thomasneuberger/filament-storage/doc/Parts.md

# Part list for the filament storage

## Enclosure
- [IKEA Billy Bookcase 80x39x202 cm](https://www.ikea.com/de/en/p/billy-bookcase-white-90401932/)
- 2x [IKEA Oxberg glass door 40x192 cm](https://www.ikea.com/de/en/p/oxberg-glass-door-white-90275617/) (in hindsight, the [Högbo glass door](https://www.ikea.com/de/en/p/hoegbo-glass-door-white-20517243/) would have been nicer)
- Some tape to seal the back

## Electronics
- Microcontroller [AzDelivery D1 mini V4 NodeMCU](https://www.az-delivery.de/en/products/d1-mini-v4-nodemcu-esp8266ex-wlan-modul-mit-usb-c-anschluss-kompatibel-mit-arduino)
- Microcontroller (alternative) [APKLVSR ESP 4 Kanal Relais Modul](https://www.amazon.de/-/en/APKLVSR-4-Channel-Development-Programming-LC-Relay-ESP-4R-A2/dp/B0D3WJMCC3) (LC Relay ESP 4R A2)
- USB-C to TTL Adapter [AzDelivery USB-C to TTL Serial Adapter for 3,3V and 5V](https://www.az-delivery.de/en/products/usb-c-zu-ttl-serial-adapter-fur-3-3v-und-5v-kompatibel-mit-ft232rl)
- Humidity sensor [AzDelivery DHT22 AM2302 Temperature sensor and air humidity sensor](https://www.az-delivery.de/en/products/dht22-temperatursensor-modul)
- Display [AZ-Delivery 1,3“ I²C OLED Display](https://www.az-delivery.de/en/products/1-3zoll-i2c-oled-display)
- Ethernet port [Willwewon RJ45 Netzwerkanschlussadapter (horizontale Buchse)](https://www.amazon.de/Willwewon-Netzwerkanschlussadapter-horizontale-Rechtwinkel-Stecker-Breakout/dp/B0GXCMWG32)
- Dehumidifier [Trotec TTP 2 E](https://de.trotec.com/shop/peltier-luftentfeuchter-ttp-2-e.html)

The humidity sensor is the raw sensor without a board. Its pins are (left to right)
1: VDD -- power supply
2: DATA -- signal
3: NULL
4: GND

Silicagel:
2 packages with each:
2.33kg
24.7cm x 18.9cm x 12.5cm = 5835 cm^3
distributed between 8 bins, each 730 cm^3
