thomasneuberger/filament-storage/src/DisplayConnection.h

#ifndef DISPLAY_CONNECTION_H
#define DISPLAY_CONNECTION_H

enum class WifiIndicatorState {
    Hidden,
    Connected,
    Connecting,
    Disconnected,
};

class DisplayConnection {
public:
    bool connect();
    bool clear();
    bool showText(const char* text, WifiIndicatorState wifiState = WifiIndicatorState::Hidden, int validSensorReadings = -1);
};

using DisplayConnector = DisplayConnection;

#endif
