thomasneuberger/filament-storage/(commit log)

2026-07-12 Add debug output and pin documentation
2026-07-12 Connect to Wifi and provide an endpoint to read the sensor values
2026-07-12 Move pin connection for more stability
    [SensorConnection.cpp]
2026-07-18 Use 3 sensors to improve accuracy
2026-07-18 Document dehumidifier switching via Home Assistant
2026-07-21 Add 3D model for the baseplate of the microcontroller case
    [hole.scad, microcontroller_baseplate.scad, pins.scad, rj45_board.scad, standoff.scad]
2026-07-24 Add cover for the microcontroller case
    [microcontroller_baseplate.scad, microcontroller_cover.scad, microcontroller_dimensions.scad, rj45_board.scad]
2026-07-26 Add display hole and standoffs to the cover
    [microcontroller_baseplate.scad, microcontroller_cover.scad, microcontroller_dimensions.scad]
2026-07-26 Create the baseplate for the sensor case
    [pins.scad, rj45_board.scad, sensor_baseplate.scad, sensor_dimensions.scad, standoff.scad]
2026-07-26 Create the cover for the sensor case
    [sensor_baseplate.scad, sensor_cover.scad, sensor_dimensions.scad]
2026-07-27 Minor meassurement corrections
    [microcontroller_cover.scad, microcontroller_dimensions.scad, rj45_board.scad]
2026-08-01 Add power cable inlet cover
    [power-inlet-cap.scad]
2026-08-01 Document cable colors
2026-08-02 Add bar holder
    [bar-holder.scad]
2026-08-02 Add a desiccant bin to the bar holder
    [bar-holder-bin.scad, bar-holder.scad, bar-holder_dimensions.scad]
2026-08-02 Wider bin holder knobs
    [bar-holder_dimensions.scad]
2026-08-08 Fix some measurements
    [bar-holder-bin.scad, bar-holder_dimensions.scad]
